ealex/power_board_for_egs002/README.md

# power_board_for_egs002
a power board for EGS002, bases on the SK68-100SA heatsink
