ealex/power_board_for_egs002/3d_models/sk68-100.FCStd

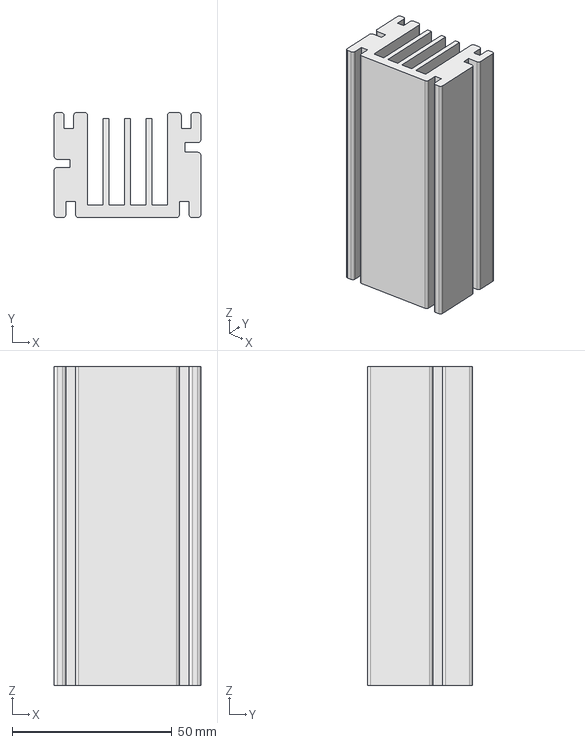
[picture p1: CAD file, 2021-12-30]
3d_models/sk68-100.FCStd
46.0 x 33.0 x 100.0 mm
