ealex/power_board_for_egs002/hardware/power_board_for_egs002/power_board_for_egs002.kicad_pcb

## KiCad design hardware/power_board_for_egs002/power_board_for_egs002.kicad_pcb (2021-12-30)

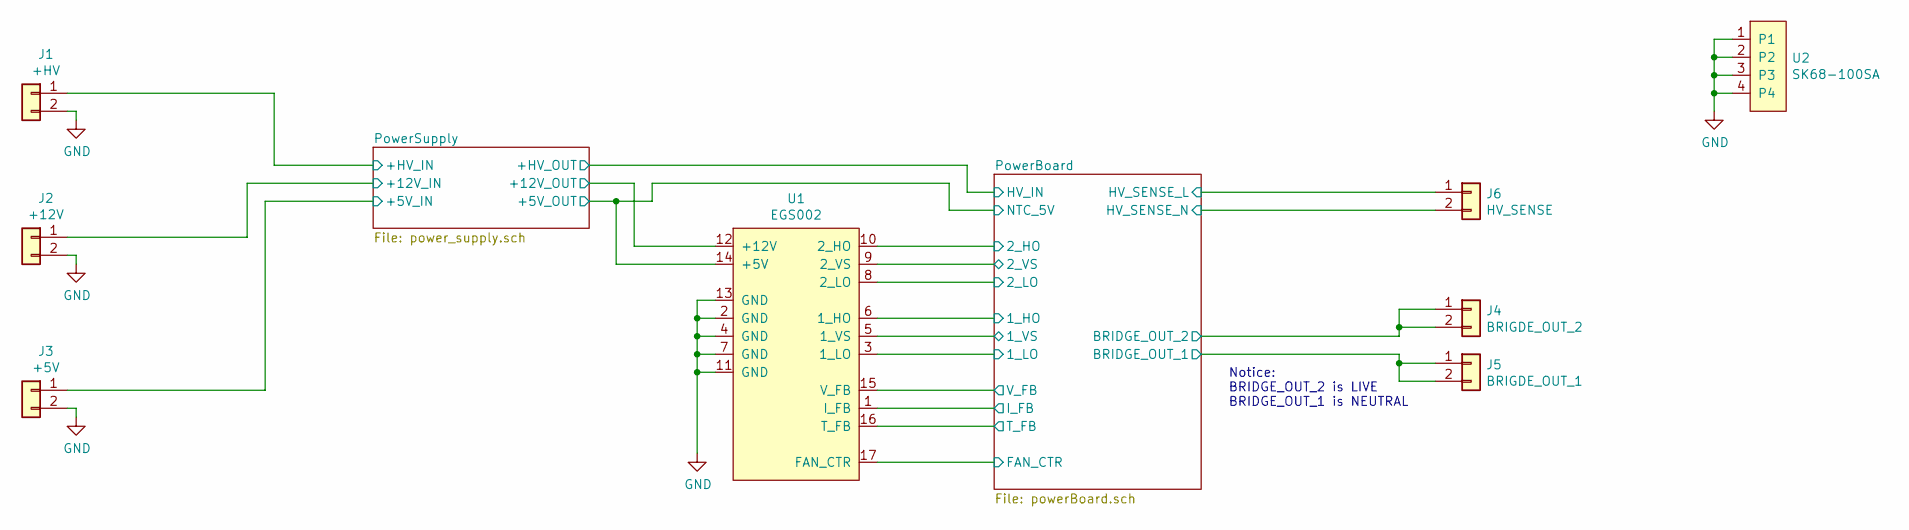
[picture p2: schematic power_board_for_egs002.sch]

Parts:
J1: +HV; conn_5.08
J2: +12V; conn_5.08
J3: +5V; conn_2.54
J4: BRIGDE_OUT_2; conn_5.08
J5: BRIGDE_OUT_1; conn_5.08
J6: HV_SENSE; conn_2.54
U1: EGS002
U2: SK68-100SA

Connections:
/PowerBoard/1_HO: U1.6 (1_HO); also elsewhere on the board
/PowerBoard/1_LO: U1.3 (1_LO); also elsewhere on the board
/PowerBoard/1_VS: J5.1, J5.2, U1.5 (1_VS); also elsewhere on the board
/PowerBoard/2_HO: U1.10 (2_HO); also elsewhere on the board
/PowerBoard/2_LO: U1.8 (2_LO); also elsewhere on the board
/PowerBoard/2_VS: J4.1, J4.2, U1.9 (2_VS); also elsewhere on the board
/PowerBoard/HV_SENSE_L: J6.1; also elsewhere on the board
/PowerBoard/HV_SENSE_N: J6.2; also elsewhere on the board
/PowerBoard/I_FB: U1.1 (I_FB); also elsewhere on the board
/PowerBoard/T_FB: U1.16 (T_FB); also elsewhere on the board
/PowerBoard/V_FB: U1.15 (V_FB); also elsewhere on the board
/PowerSupply/+5V_IN: J3.1, U1.14 (+5V); also elsewhere on the board
/PowerSupply/+12V_IN: J2.1; also elsewhere on the board
/PowerSupply/+12V_OUT: U1.12 (+12V); also elsewhere on the board
/PowerSupply/+HV_IN: J1.1; also elsewhere on the board
GND: J1.2, J2.2, J3.2, U1.2 (GND), U1.4 (GND), U1.7 (GND), U1.11 (GND), U1.13 (GND), U2.1, U2.2, U2.3, U2.4; also elsewhere on the board

Notes on the sheet:
Notice: BRIDGE_OUT_2 is LIVE BRIDGE_OUT_1 is NEUTRAL

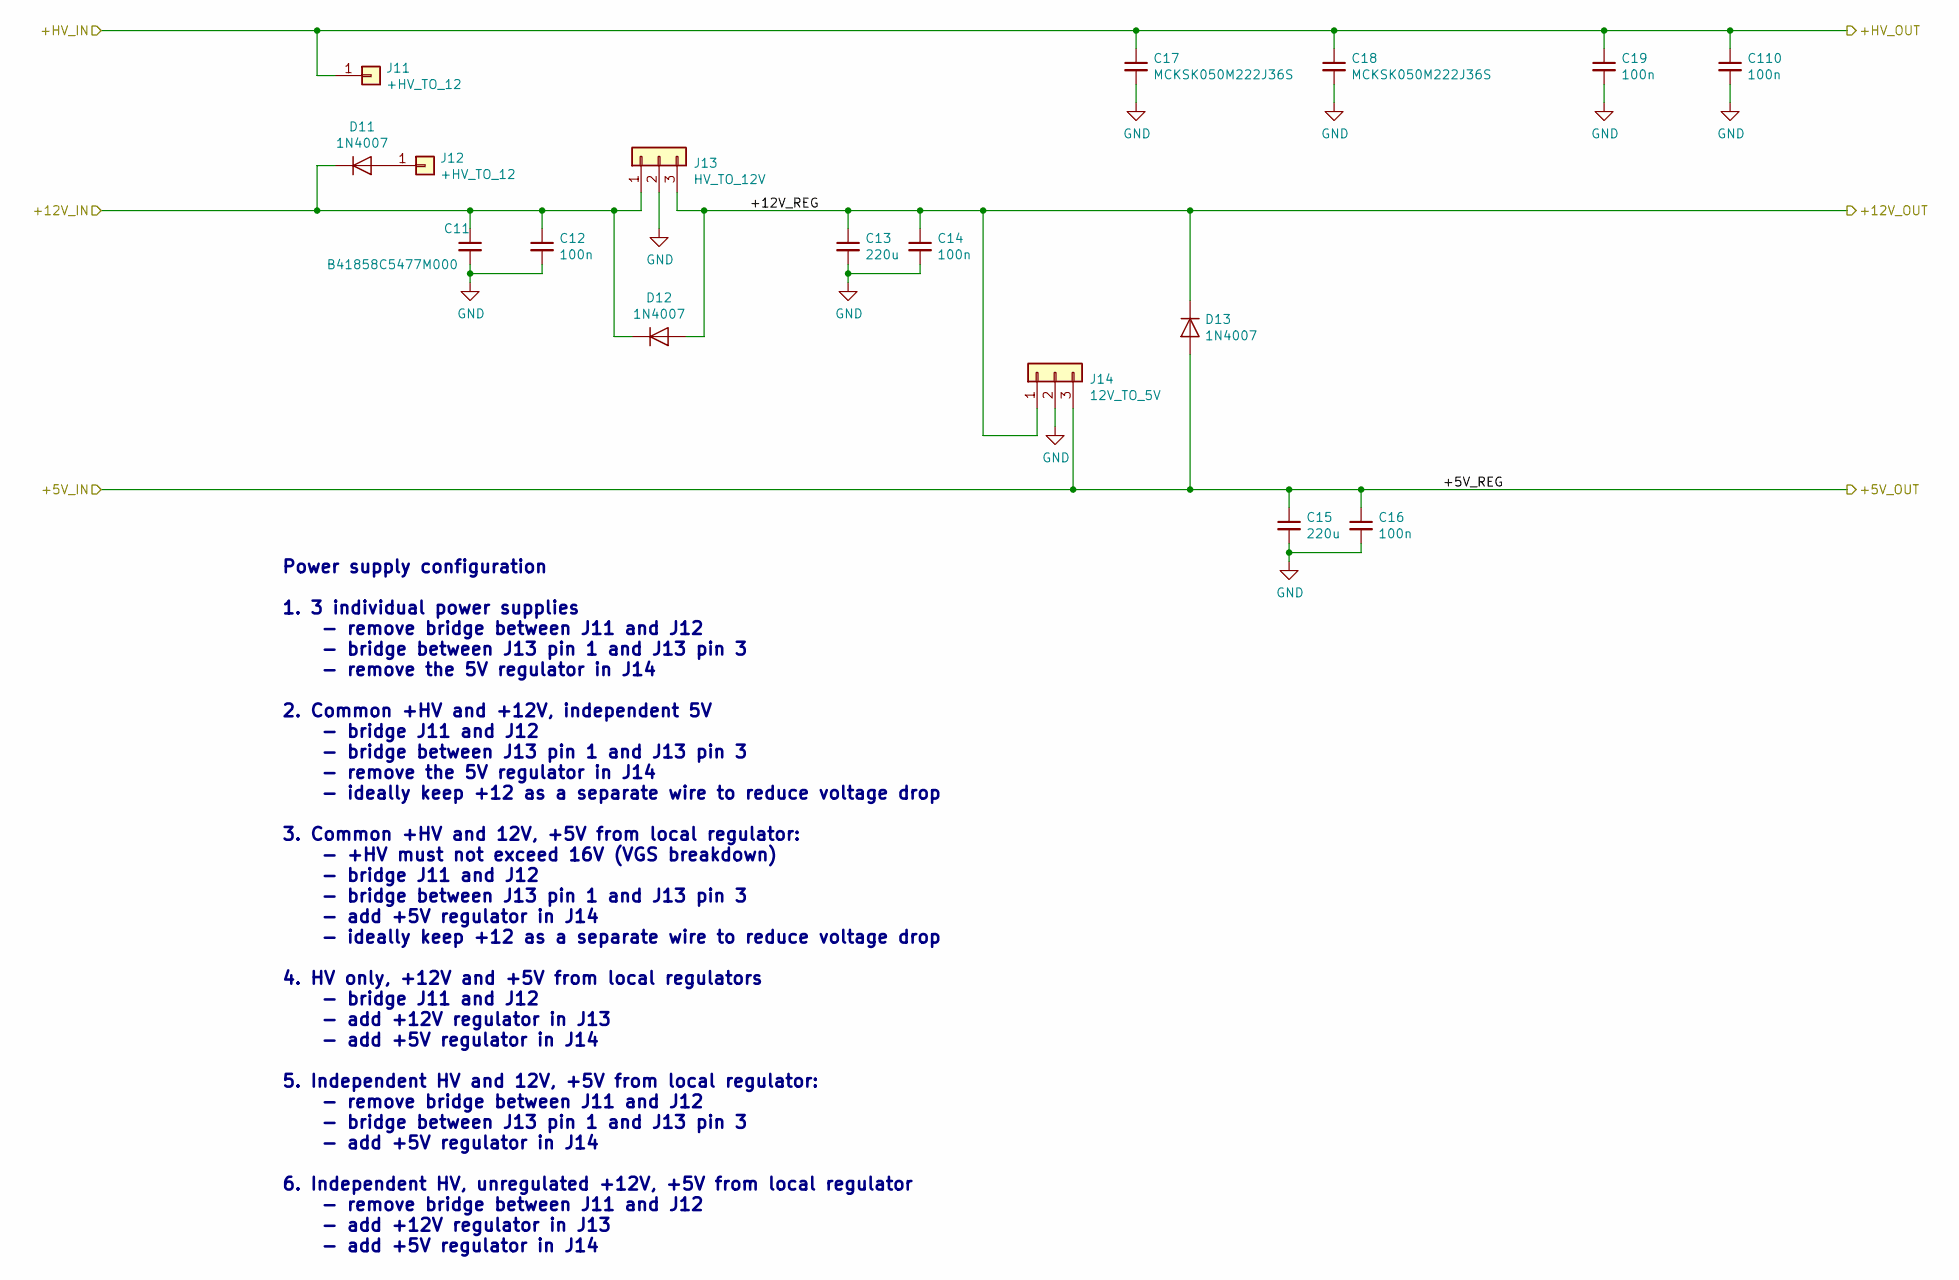
[picture p3: schematic power_supply.sch]

Parts:
C11: B41858C5477M000; CP_Radial_D10.0mm_P5.00mm
C12, C14, C16, C19, C110: 100n; C_1206_3216Metric
C13, C15: 220u; CP_Radial_D10.0mm_P5.00mm
C17, C18: MCKSK050M222J36S; CP_Radial_D16.0mm_P7.50mm
D11, D12, D13: 1N4007; D_DO-41_SOD81_P5.08mm_Vertical_AnodeUp
J11, J12: +HV_TO_12; PinHeader_1x01_P2.54mm_Vertical
J13: HV_TO_12V; TO-220-3_Vertical
J14: 12V_TO_5V; TO-220-3_Vertical

Connections:
/PowerSupply/+5V_IN: C15.1, C16.1, D13.2 (A), J14.3; also elsewhere on the board
/PowerSupply/+12V_IN: C11.1, C12.1, D11.1 (K), D12.1 (K), J13.1; also elsewhere on the board
/PowerSupply/+12V_OUT: C13.1, C14.1, D12.2 (A), D13.1 (K), J13.3, J14.1; also elsewhere on the board
/PowerSupply/+HV_IN: C17.1, C18.1, C19.1, C110.1, J11.1; also elsewhere on the board
GND: C11.2, C12.2, C13.2, C14.2, C15.2, C16.2, C17.2, C18.2, C19.2, C110.2, J13.2, J14.2; also elsewhere on the board
unnamed: D11.2 (A), J12.1

Notes on the sheet:
Power supply configuration 1. 3 individual power supplies - remove bridge between J11 and J12 - bridge between J13 pin 1 and J13 pin 3 - remove the 5V regulator in J14 2. Common +HV and +12V, independent 5V - bridge J11 and J12 - bridge between J13 pin 1 and J13 pin 3 - remove the 5V regulator in J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

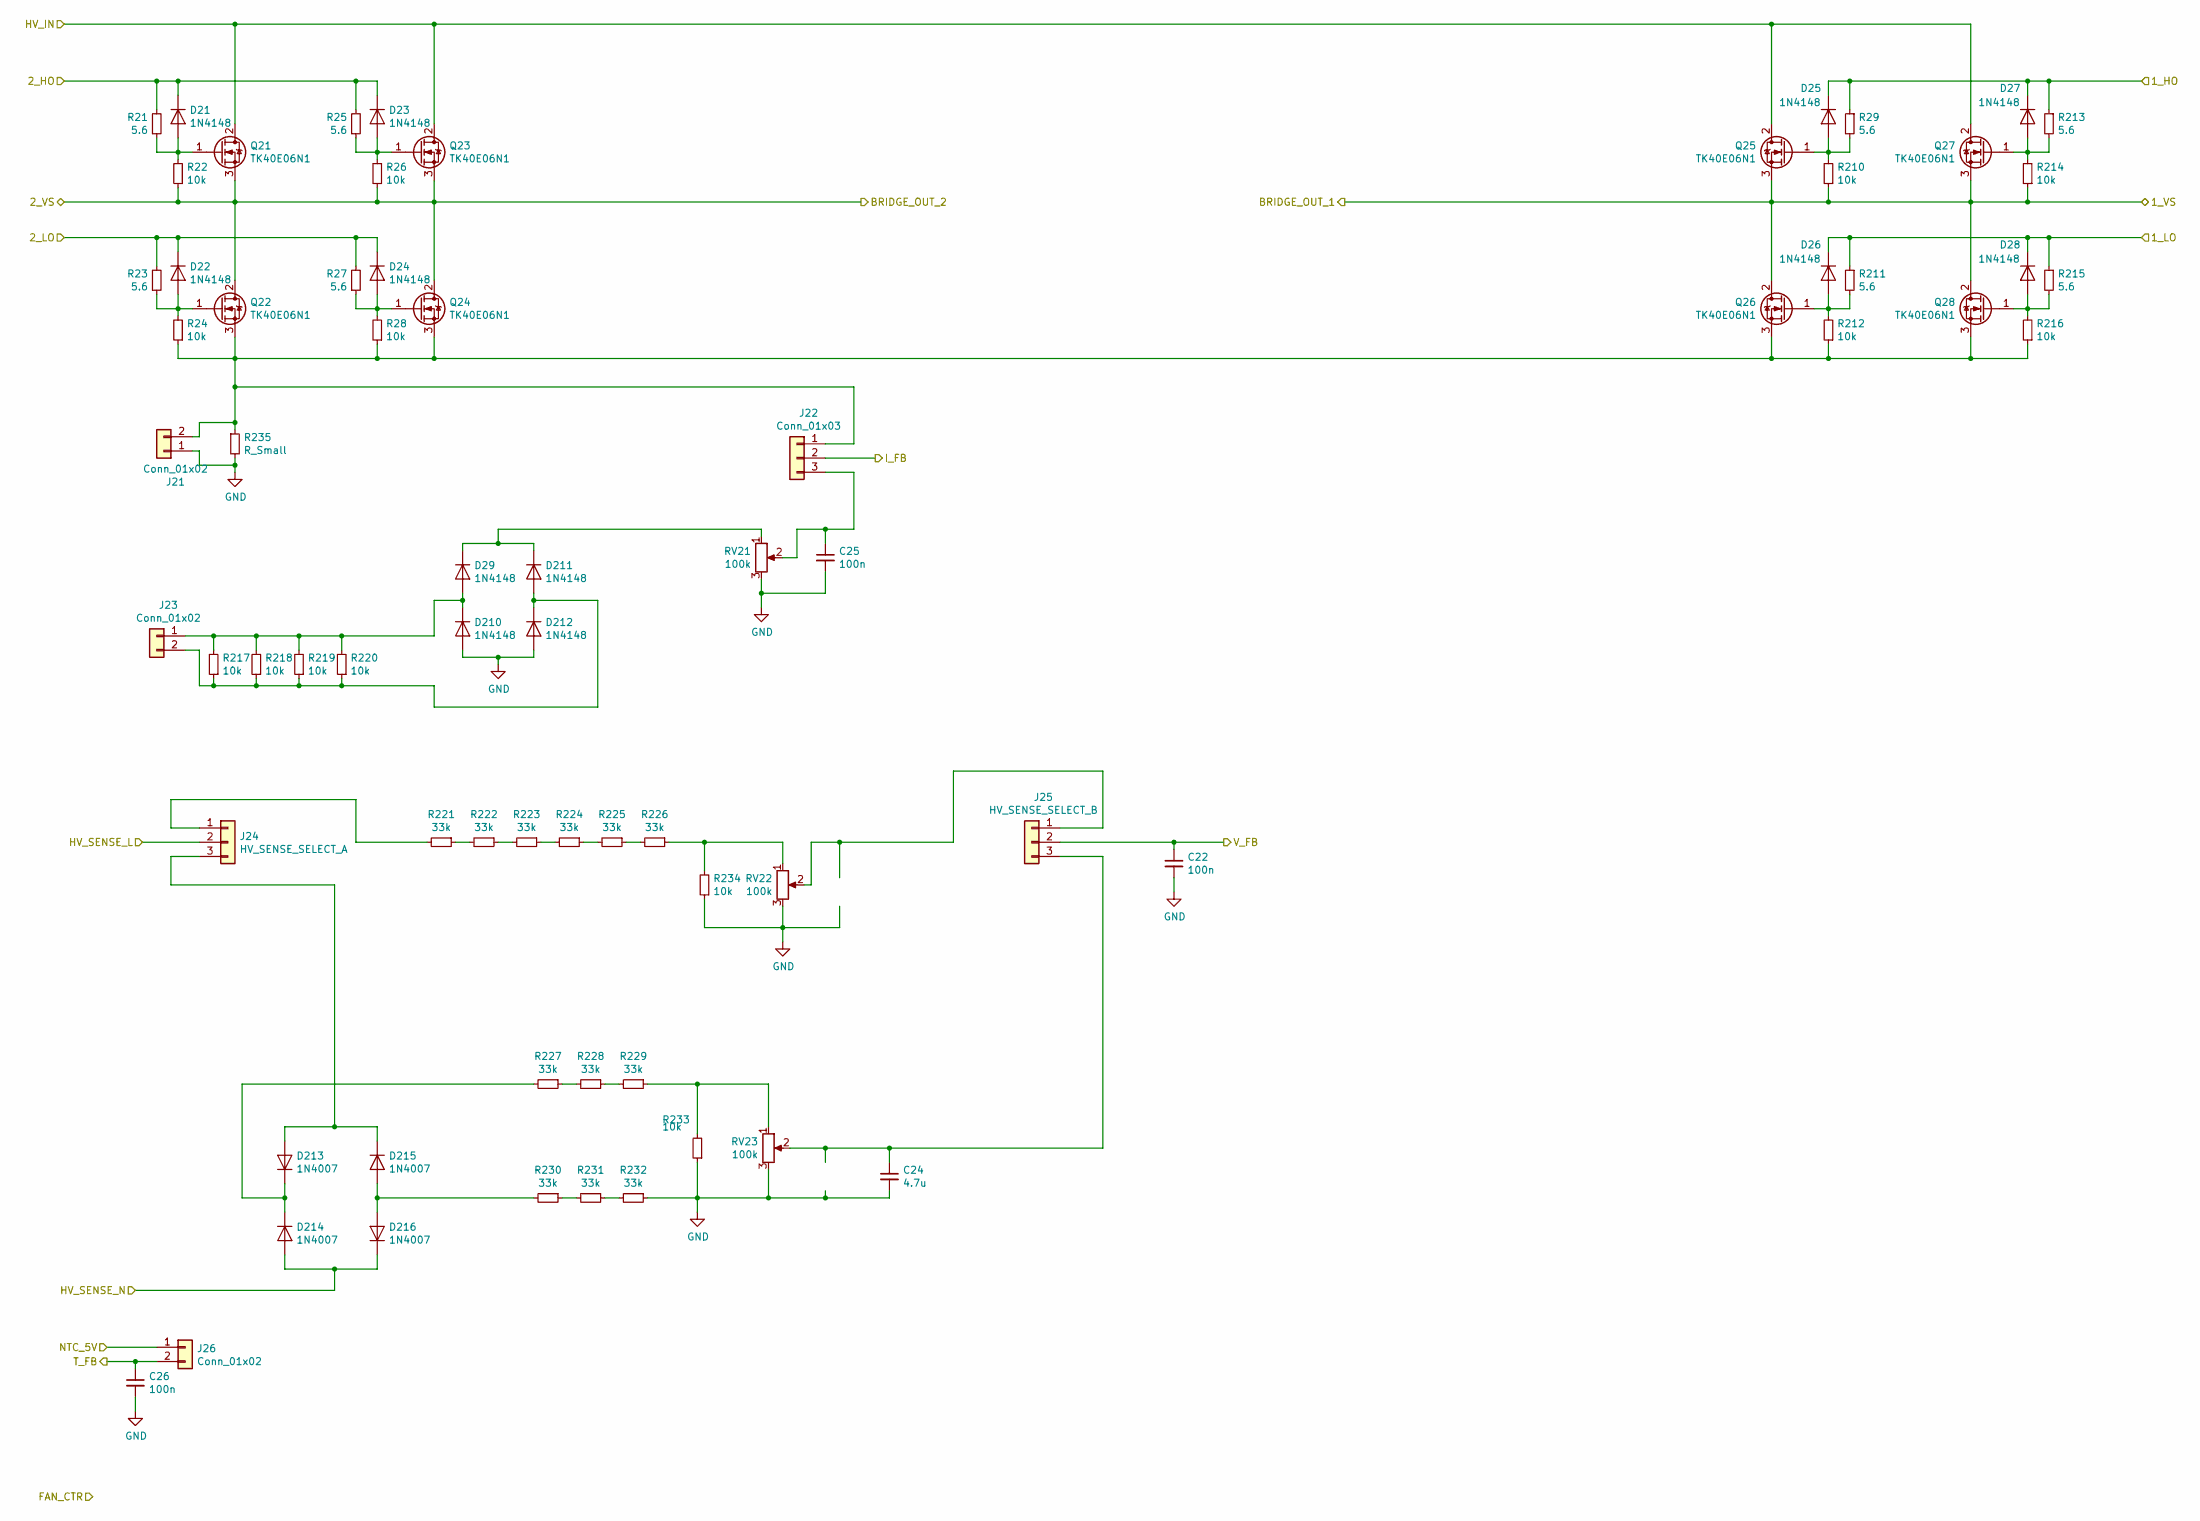
[picture p4: schematic powerBoard.sch]

Parts:
C22, C25, C26: 100n; C_1206_3216Metric
C24: 4.7u; CP_Radial_D5.0mm_P2.50mm
D21, D22, D23, D24, D25, D26, D27, D28, D29, D210, D211, D212: 1N4148; D_DO-35_SOD27_P2.54mm_Vertical_AnodeUp
D213, D214, D215, D216: 1N4007; D_DO-41_SOD81_P5.08mm_Vertical_AnodeUp
J21: Conn_01x02; conn_5.08
J22: Conn_01x03; PinHeader_1x03_P2.54mm_Vertical
J23, J26: Conn_01x02; conn_2.54
J24: HV_SENSE_SELECT_A; PinHeader_1x03_P2.54mm_Vertical
J25: HV_SENSE_SELECT_B; PinHeader_1x03_P2.54mm_Vertical
Q21, Q22, Q23, Q24, Q25, Q26, Q27, Q28: TK40E06N1; TO-220-3_Vertical
R21, R23, R25, R27, R29, R211, R213, R215: 5.6; R_1206_3216Metric
R22, R24, R26, R28, R210, R212, R214, R216, R217, R218, R219, R220, R233, R234: 10k; R_1206_3216Metric
R221, R222, R223, R224, R225, R226, R227, R228, R229, R230, R231, R232: 33k; R_1206_3216Metric
R235: R_Small; R_1206_3216Metric
RV21, RV22, RV23: 100k; r_multiturn

Connections:
/PowerBoard/1_HO: D25.1 (K), D27.1 (K), R29.1, R213.1; also elsewhere on the board
/PowerBoard/1_LO: D26.1 (K), D28.1 (K), R211.1, R215.1; also elsewhere on the board
/PowerBoard/1_VS: Q25.3 (S), Q26.2 (D), Q27.3 (S), Q28.2 (D), R210.1, R214.1; also elsewhere on the board
/PowerBoard/2_HO: D21.1 (K), D23.1 (K), R21.2, R25.2; also elsewhere on the board
/PowerBoard/2_LO: D22.1 (K), D24.1 (K), R23.2, R27.2; also elsewhere on the board
/PowerBoard/2_VS: Q21.3 (S), Q22.2 (D), Q23.3 (S), Q24.2 (D), R22.1, R26.1; also elsewhere on the board
/PowerBoard/HV_SENSE_L: J24.2; also elsewhere on the board
/PowerBoard/HV_SENSE_N: D214.2 (A), D216.1 (K); also elsewhere on the board
/PowerBoard/I_FB: J22.2; also elsewhere on the board
/PowerBoard/T_FB: C26.1, J26.2; also elsewhere on the board
/PowerBoard/V_FB: C22.1, J25.2; also elsewhere on the board
/PowerSupply/+5V_IN: J26.1; also elsewhere on the board
/PowerSupply/+HV_IN: Q21.2 (D), Q23.2 (D), Q25.2 (D), Q27.2 (D); also elsewhere on the board
GND: C22.2, C24.2, C25.2, C26.2, D210.2 (A), D212.2 (A), J21.1, R232.1, R233.1, R234.1, R235.2, RV21.3, RV22.3, RV23.3; also elsewhere on the board
unnamed: C24.1, J25.3, RV23.2
unnamed: C25.1, J22.3, RV21.2
unnamed: D21.2 (A), Q21.1 (G), R21.1, R22.2
unnamed: D22.2 (A), Q22.1 (G), R23.1, R24.2
unnamed: D23.2 (A), Q23.1 (G), R25.1, R26.2
unnamed: D24.2 (A), Q24.1 (G), R27.1, R28.2
unnamed: D25.2 (A), Q25.1 (G), R29.2, R210.2
unnamed: D26.2 (A), Q26.1 (G), R211.2, R212.2
unnamed: D27.2 (A), Q27.1 (G), R213.2, R214.2
unnamed: D28.2 (A), Q28.1 (G), R215.2, R216.2
unnamed: D29.2 (A), D210.1 (K), J23.1, R217.2, R218.2, R219.2, R220.2
unnamed: D29.1 (K), D211.1 (K), RV21.1
unnamed: D211.2 (A), D212.1 (K), J23.2, R217.1, R218.1, R219.1, R220.1
unnamed: D213.1 (K), D214.1 (K), R227.2
unnamed: D213.2 (A), D215.1 (K), J24.3
unnamed: D215.2 (A), D216.2 (A), R230.2
unnamed: J21.2, J22.1, Q22.3 (S), Q24.3 (S), Q26.3 (S), Q28.3 (S), R24.1, R28.1, R212.1, R216.1, R235.1
unnamed: J24.1, R221.2
unnamed: J25.1, RV22.2
unnamed: R221.1, R222.2
unnamed: R222.1, R223.2
unnamed: R223.1, R224.2
unnamed: R224.1, R225.2
unnamed: R225.1, R226.2
unnamed: R226.1, R234.2, RV22.1
unnamed: R227.1, R228.2
unnamed: R228.1, R229.2
unnamed: R229.1, R233.2, RV23.1
unnamed: R230.1, R231.2
unnamed: R231.1, R232.2

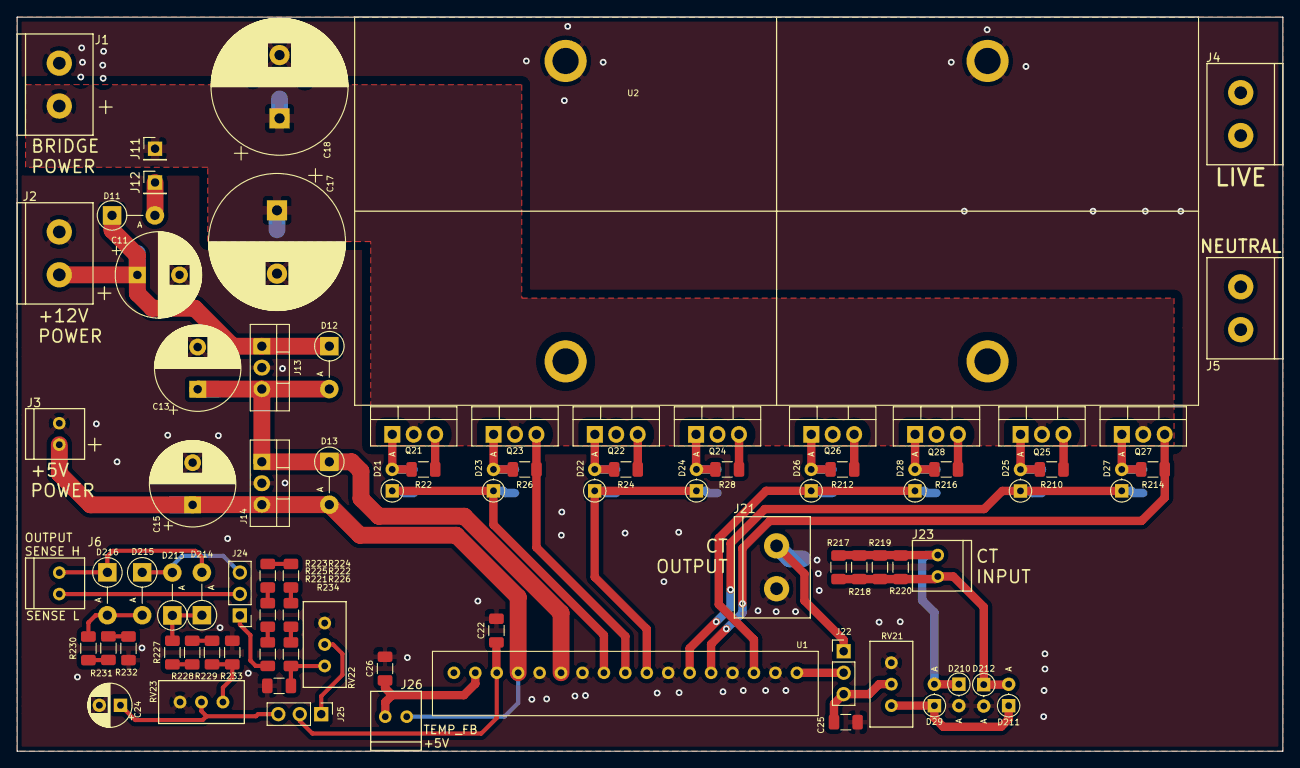
[picture p5: board power_board_for_egs002.kicad_pcb from above]

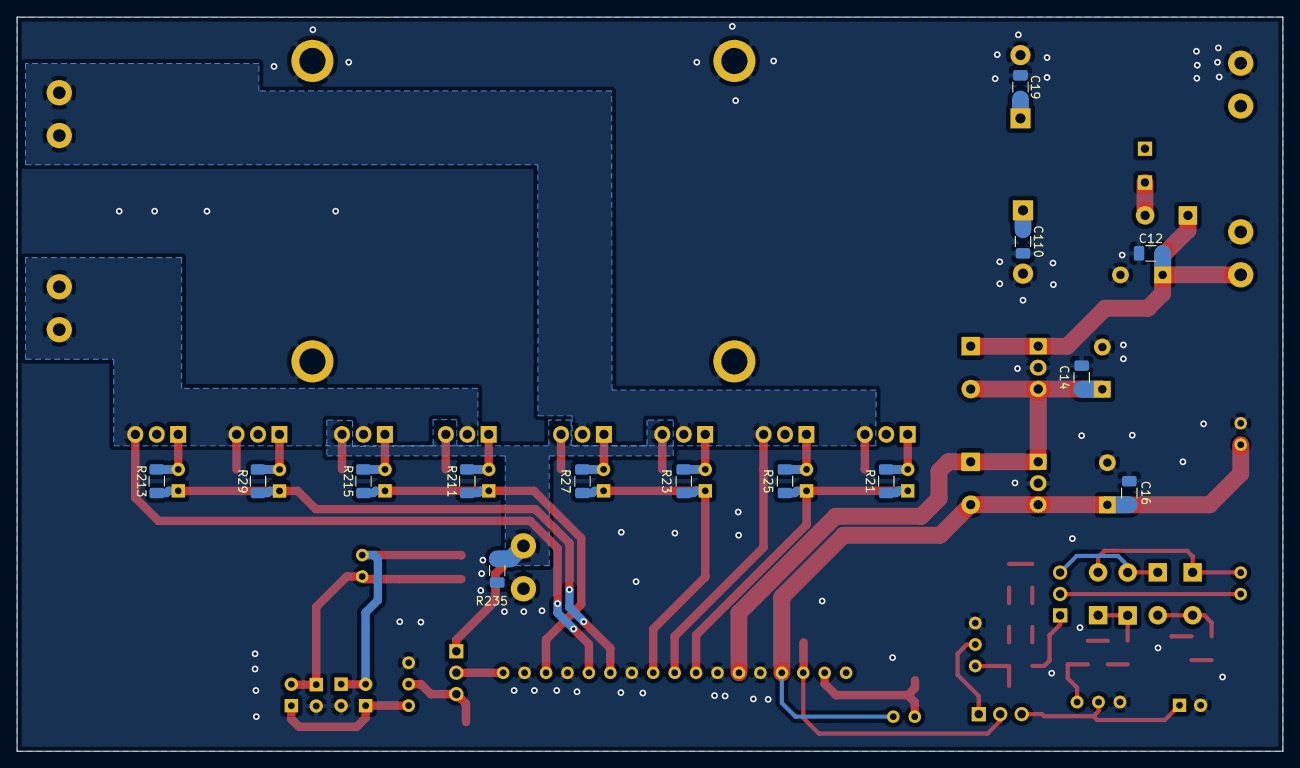
[picture p6: board power_board_for_egs002.kicad_pcb from below]

Board: 2 copper layers, 150.0 x 87.0 mm, 97 parts (14 on the bottom side), 47 nets.
