ealex/power_board_for_egs002/(commit log)

2021-12-07 start working on the schematic
    [powerBoard.sch, power_board_for_egs002.kicad_pcb, power_board_for_egs002.sch, power_supply.sch]
2021-12-09 continue sch update
    [powerBoard.sch, power_board_for_egs002.sch, power_supply.sch]
2021-12-10 start adding footprints
    [powerBoard.sch, power_board_for_egs002.kicad_pcb, power_board_for_egs002.sch, power_supply.sch]
2021-12-11 add 3d model for heatsink
    [sk68-100.FCStd]
2021-12-11 update footprints
2021-12-11 continue sch dev
    [powerBoard.sch, power_board_for_egs002.kicad_pcb, power_board_for_egs002.sch, power_supply.sch]
2021-12-14 continue pcb work
    [powerBoard.sch, power_board_for_egs002.kicad_pcb, power_supply.sch]
2021-12-15 update layout
    [power_board_for_egs002.kicad_pcb]
